MrMuffinooo/Kubkuino/Kubkuino_Infrared_PreRelease/Board_KiCAD_IR/Parts.xlsx

Oznaczenie | Wartość | Obudowa | Notes
C1 | 100nF | 1206
C2 | 1uF | A | (Tantalowy)
C3 | 1uF | A | (Tantalowy)
C4 | 100nF | 1206
C5 | 22pF | 0805
C6 | 22pF | 0805
D1 | 1N4007 | SMA
D2 | 1N4007 | SMA
D3 | 1N4007 | SMA
D4 | 1N4007 | SMA
D7 | LED_R | 1206
D8 | LED_G | 1206
D9 | LED_B | 1206
J1 | Piezo | Goldpin 1x2 żeński
J2 | AC/DC In (12V) | Goldpin 1x2 żeński
J3 | Prog | Goldpin 2x3 męski
J4 | Czujnik | Goldpin 1x4 żeński | GY-906
J6 | LCD | Goldpin 1x4 żeński | SSD1306 32x128 mono
J7 | Button | Goldpin 1x2 żeński
J8 | Bluetooth | Goldpin 1x6 żeński | HC-05 z wyprowadzeniami
Q1 | S8050 | TO-92
R1 | 220 | 1206
R2 | 220 | 1206
R3 | 220 | 1206
R4 | 1k | 1206
R5 | 1k | 1206
R6 | 4k7 | 1206
R7 | 4k7 | 1206
RJ1 | 0 | 1206
RJ2 | 0 | 1206
SW1 | Reset | 6mm x 6mm
U1 | LM7805_TO220 | TO-263-2
U2 | ATMEGA328P-PU | TQFP32
Y1 | Crystal | HC49 | 16MHz
