MrMuffinooo/Kubkuino/Kubkuino_Infrared_PreRelease/Board_KiCAD_IR/PartsWithPrices.pdf

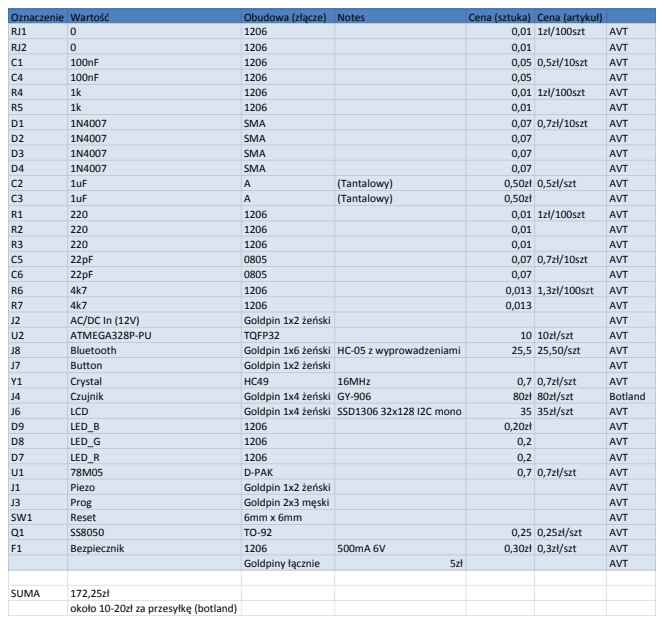
[picture p1: page 1]

około 10-20zł za przesyłkę (botland)
