MrMuffinooo/Kubkuino/Kubkuino_Infrared_PreRelease/Board_KiCAD_IR/Board.kicad_pcb

## KiCad design Kubkuino_Infrared_PreRelease/Board_KiCAD_IR/Board.kicad_pcb (2017-11-12)

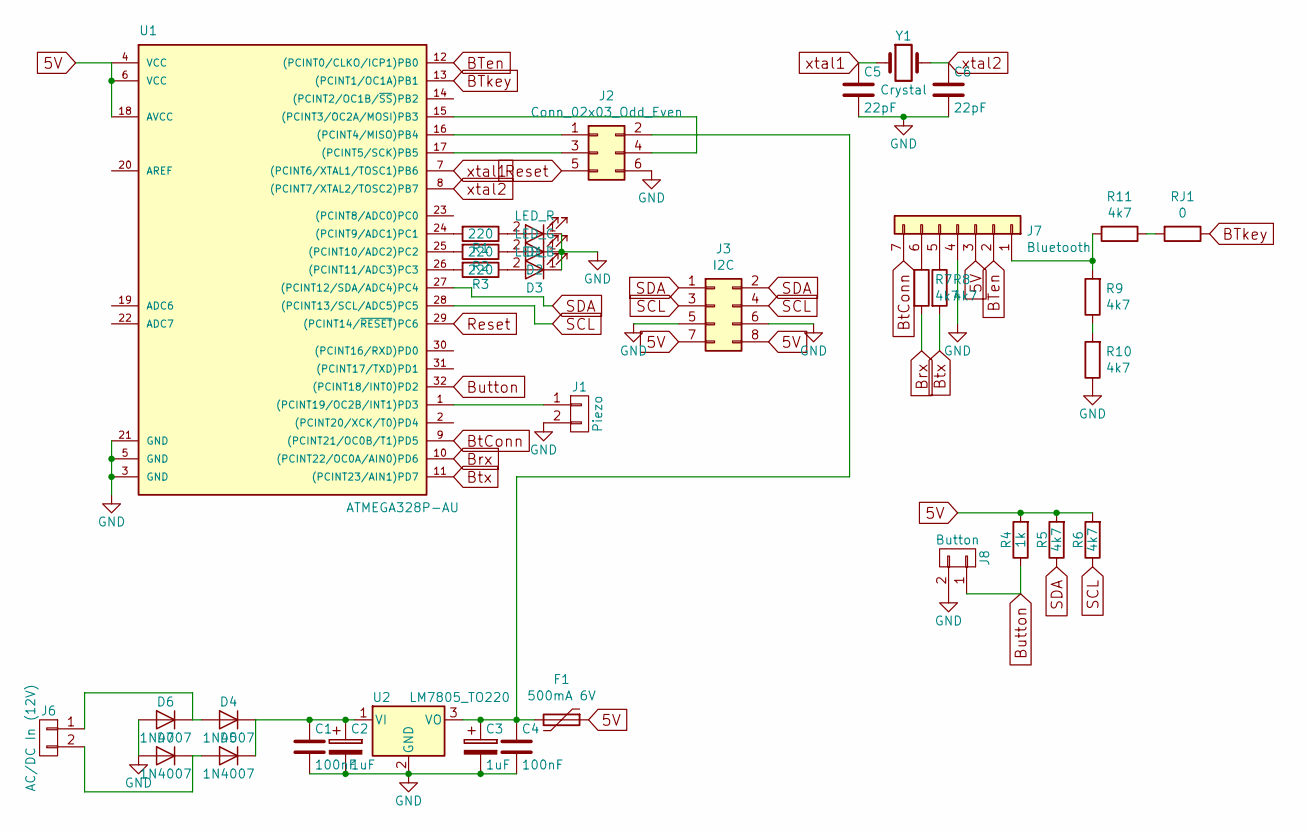
[picture p2: schematic Board.sch]

Parts:
C1, C4: 100nF; C_1206
C2, C3: 1uF; CP_Tantalum_Case-A_EIA-3216-18_Hand
C5, C6: 22pF; C_0805_HandSoldering
D1: LED_R; LED_1206
D2: LED_G; LED_1206
D3: LED_B; LED_1206
D4, D5, D6, D7: 1N4007; D_SMA
F1: 500mA 6V; SMD-1206_Pol
J1: Piezo; Pin_Header_Straight_1x02_Pitch2.54mm_SMD_Pin1Left
J2: Conn_02x03_Odd_Even; Pin_Header_Straight_2x03_Pitch2.54mm
J3: I2C; Socket_Strip_Straight_2x04_Pitch2.54mm_SMD
J6: AC/DC In (12V); Socket_Strip_Angled_1x02_Pitch2.54mm
J7: Bluetooth; Pin_Header_Straight_1x07_Pitch2.54mm_SMD_Pin1Left
J8: Button; Pin_Header_Straight_1x02_Pitch2.54mm_SMD_Pin1Left
R1, R2, R3: 220; R_1206
R4: 1k; R_1206
R5, R6, R7, R8, R9, R10, R11: 4k7; R_1206
RJ1: 0; R_1206
U1: ATMEGA328P-AU; TQFP-32_7x7mm_Pitch0.8mm
U2: LM7805_TO220; TO-252-2
Y1: Crystal; Crystal_SMD_HC49-SD_HandSoldering

Connections:
5V: F1.1, J3.7, J3.8, J7.3, R4.2, R5.2, R6.2, U1.4 (VCC), U1.6 (VCC), U1.18 (AVCC)
BTen: J7.2, U1.12 ((PCINT0/CLKO/ICP1)PB0)
BTkey: RJ1.1, U1.13 ((PCINT1/OC1A)PB1)
Brx: R7.2, U1.10 ((PCINT22/OC0A/AIN0)PD6)
BtConn: J7.7, U1.9 ((PCINT21/OC0B/T1)PD5)
Btx: R8.2, U1.11 ((PCINT23/AIN1)PD7)
Button: J8.1, R4.1, U1.32 ((PCINT18/INT0)PD2)
GND: C1.2, C2.2, C3.2, C4.2, C5.2, C6.2, D1.1 (K), D2.1 (K), D3.1 (K), D6.2 (A), D7.2 (A), J1.2, J2.6, J3.5, J3.6, J7.4, J8.2, R10.1, U1.3 (GND), U1.5 (GND), U1.21 (GND), U2.2 (GND)
unnamed: C1.1, C2.1, D4.1 (K), D5.1 (K), U2.1 (VI)
unnamed: C3.1, C4.1, F1.2, J2.2, U2.3 (VO)
unnamed: D1.2 (A), R1.1
unnamed: D2.2 (A), R2.1
unnamed: D3.2 (A), R3.1
unnamed: D4.2 (A), D6.1 (K), J6.1
unnamed: D5.2 (A), D7.1 (K), J6.2
unnamed: J1.1, U1.1 ((PCINT19/OC2B/INT1)PD3)
unnamed: J2.1, U1.16 ((PCINT4/MISO)PB4)
unnamed: J2.3, U1.17 ((PCINT5/SCK)PB5)
unnamed: J2.4, U1.15 ((PCINT3/OC2A/MOSI)PB3)
unnamed: J7.1, R9.2, R11.2
unnamed: J7.5, R8.1
unnamed: J7.6, R7.1
unnamed: R1.2, U1.24 ((PCINT9/ADC1)PC1)
unnamed: R2.2, U1.25 ((PCINT10/ADC2)PC2)
unnamed: R3.2, U1.26 ((PCINT11/ADC3)PC3)
unnamed: R9.1, R10.2
unnamed: R11.1, RJ1.2
Reset: J2.5, U1.29 ((PCINT14/~RESET~)PC6)
SCL: J3.3, J3.4, R6.1, U1.28 ((PCINT13/SCL/ADC5)PC5)
SDA: J3.1, J3.2, R5.1, U1.27 ((PCINT12/SDA/ADC4)PC4)
xtal1: C5.1, U1.7 ((PCINT6/XTAL1/TOSC1)PB6), Y1.1
xtal2: C6.1, U1.8 ((PCINT7/XTAL2/TOSC2)PB7), Y1.2

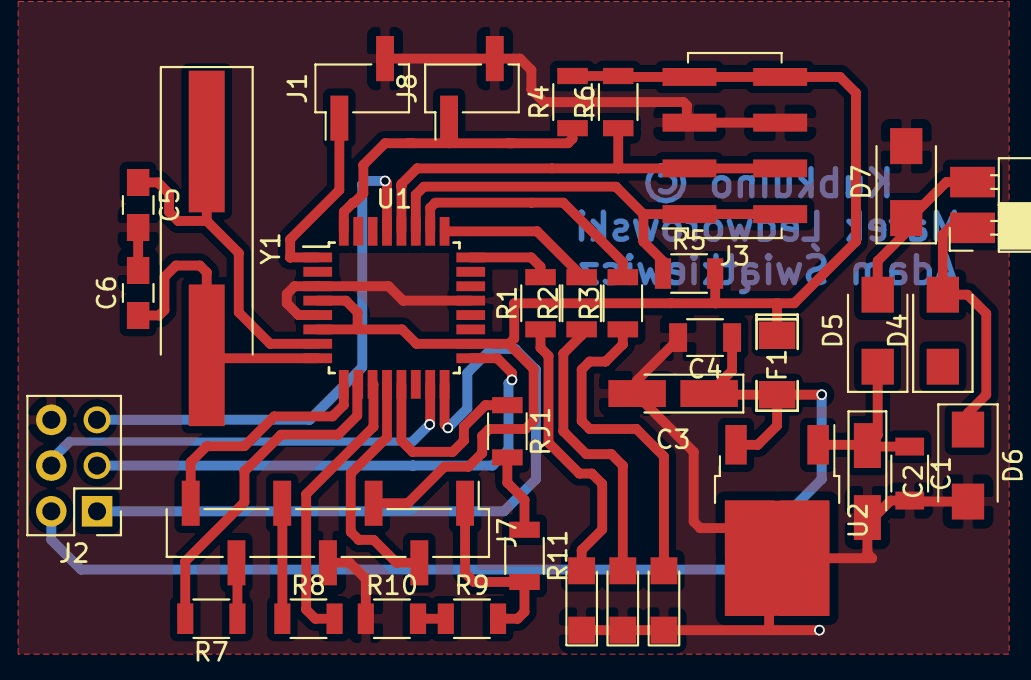
[picture p3: board Board.kicad_pcb from above]

Board: 2 copper layers, 35 parts (0 on the bottom side), 32 nets.
