MrMuffinooo/Kubkuino/Kubkuino_Infrared_PreRelease/vars.h

//Stare
#define ctl 2 //Przycisk
#define buzz 3 //Buzzer
#define btpow 4 //Zasilanie BT
#define btx 5 //Bluetooth TX
#define brx 6 //Bluetooth RX
#define btkey 7 //Bt Key
#define rled A1
#define gled A2
#define bled A3
//Nowe
/*#define ctl 2 //Przycisk
  #define buzz 3 //Buzzer
  #define btpow 9 //Zasilanie BT
  #define btx 7 //Bluetooth TX
  #define brx 5 //Bluetooth RX
  #define btconn 6 //BT connected
  #define btkey 8 //BT Key
  #define rled A1
  #define gled A2
  #define bled A3*/
#if F_CPU != 16000000
#undef F_CPU
#define F_CPU 16000000
#endif

#if (SSD1306_LCDHEIGHT != 64)
#error("Height incorrect, please fix Adafruit_SSD1306.h!");
#endif

/* Pomiary */
int hot, cold;
double pomiar = 0, poppomiar = 0;

/* Bluetooth */
bool conn = false; //Polaczony?

/* Alarm */
uint8_t alarmState = 0b000;
bool glosny = false; //Czy ma piszczec?

/* Zasilanie */
bool lcdon = true;
bool ledon = true;
bool dimlcd = false;

PROGMEM const uint8_t icon[] = { //Bluetooth
  0b00000011, 0b00000000,
  0b00000011, 0b11000000,
  0b00000011, 0b11000000,
  0b00110011, 0b00110000,
  0b00110011, 0b00001100,
  0b00001111, 0b00001100,
  0b00001111, 0b00110000,
  0b00000011, 0b11000000,
  0b00000011, 0b11000000,
  0b00001111, 0b00110000,
  0b00001111, 0b00001100,
  0b00110011, 0b00001100,
  0b00110011, 0b00110000,
  0b00000011, 0b11000000,
  0b00000011, 0b11000000,
  0b00000011, 0b00000000
};

PROGMEM const uint8_t state_hot[] = {
  0b00000110, 0b00000110, 0b01111000,
  0b00000110, 0b00000110, 0b01111000,
  0b00011110, 0b01111000, 0b00011000,
  0b00011110, 0b01111000, 0b00011000,
  0b01111000, 0b00011000, 0b01111000,
  0b01111000, 0b00011000, 0b01111000,
  0b01111000, 0b00011000, 0b01100000,
  0b01111000, 0b00011000, 0b01100000,
  0b00011110, 0b00000000, 0b01100000,
  0b00011110, 0b00000000, 0b01100000,
  0b00011110, 0b00011110, 0b01111000,
  0b00011110, 0b00011110, 0b01111000,
  0b01111000, 0b01111000, 0b00011110,
  0b01111000, 0b01111000, 0b00011110,
  0b00000000, 0b00011000, 0b00000000,
  0b00000000, 0b00011000, 0b00000000,
};

PROGMEM const uint8_t state_ready[] = {
  0b00000000, 0b00000000, 0b00110000,
  0b00000000, 0b00000000, 0b00110000,
  0b00000000, 0b00000000, 0b11111100,
  0b00000000, 0b00000000, 0b11111100,
  0b00000000, 0b00000011, 0b11110000,
  0b00000000, 0b00000011, 0b11110000,
  0b00000000, 0b00001111, 0b11000000,
  0b00000000, 0b00001111, 0b11000000,
  0b00001100, 0b00111111, 0b00000000,
  0b00001100, 0b00111111, 0b00000000,
  0b00111111, 0b11111100, 0b00000000,
  0b00111111, 0b11111100, 0b00000000,
  0b00001111, 0b11110000, 0b00000000,
  0b00001111, 0b11110000, 0b00000000,
  0b00000011, 0b11000000, 0b00000000,
  0b00000011, 0b11000000, 0b00000000,
};

PROGMEM const uint8_t state_cold[] = {
  0b00000000, 0b00000000, 0b00000000,
  0b00000000, 0b00000000, 0b00000000,
  0b00000111, 0b10000001, 0b11100000,
  0b00000111, 0b10000001, 0b11100000,
  0b00000111, 0b10000001, 0b11100000,
  0b00000111, 0b10000001, 0b11100000,
  0b00000000, 0b00000000, 0b00000000,
  0b00000000, 0b00000000, 0b00000000,
  0b00000001, 0b11111111, 0b10000000,
  0b00000001, 0b11111111, 0b10000000,
  0b00000111, 0b11111111, 0b11100000,
  0b00000111, 0b11111111, 0b11100000,
  0b00000111, 0b10000001, 0b11100000,
  0b00000111, 0b10000001, 0b11100000,
  0b00000000, 0b00000000, 0b00000000,
  0b00000000, 0b00000000, 0b00000000,
};
