MrMuffinooo/Kubkuino/(commit log)

2017-11-05 added parts list
    [Parts.xlsx]
2017-11-06 cleaning, organizing
    added DEBUG option during compilation
    splashscreen
    parts with prices (PL)
    slight board changes
    [Board.kicad_pcb, Board.sch, KubkuinoDNO.fzz, Parts.xlsx]
2017-11-12 Updates
    Finished new board
    Changed SSD1306 to 128x64
    Major RAM optimization
    Main routine optimizations
    Set up display layout
    [Board.kicad_pcb, Board.sch]
